Eddyyy/Rocket_FC_Hardware/prototype_rocket_fc/rocket_BOM.ods

Part | Ref | Manufacturer | Part Number | Quantity | Price ($) | Footprint(Package) | Description
Cin | C1,C2 | TDK | C1608X5R1E106M080AC | 2 | 0.2 | 0603 | Cap: 10 µF Total Derated Cap: 680 nF VDC: 25 V ESR: 4.64 mΩ
L1 | L1 | Bourns | SRU8043-150Y | 1 | 1.34 | L_SRU8043 | L: 15 µH DCR: 46 mΩ IDC: 2 A
Cboot | C4 | Kemet | C0603X104K4RACTU | 1 | 0.09 | 0603 | Cap: 100 nF Total Derated Cap: 100 nF VDC: 16 V ESR: 1 mΩ
Cinx | C3 | MuRata | GRM188R71H104KA93D | 1 | 0.02 | 0603 | Cap: 100 nF Total Derated Cap: 93 nF VDC: 50 V ESR: 20 mΩ
U1 | U6 | Texas Instruments | LMR50410XFDBVR | 1 | 0.4 | SOT-23-6 | SIMPLE SWITCHER 4-V TO 36-V, 1-A
Cout | C5,C6 | MuRata | GRM31CR71A226KE15L | 2 | 0.82 | 1206_190 | Cap: 22 µF Total Derated Cap: 27 µF VDC: 10 V ESR: 3.59 mΩ
Renb | R2 | Vishay-Dale | CRCW0603200KFKEA | 1 | 0.01 | 0603 | Resistance: 200 kΩ Tolerance: 1.0% Power: 100 mW
Rent | R1 | Vishay-Dale | CRCW0805665KFKEA | 1 | 0.01 | 0805 | Resistance: 665 kΩ Tolerance: 1.0% Power: 125 mW
Rfbb | R4 | Vishay-Dale | CRCW060322K1FKEA | 1 | 0.01 | 0603 | Resistance: 22.1 kΩ Tolerance: 1.0% Power: 100 mW
Rfbt | R3 | Vishay-Dale | CRCW060388K7FKEA | 1 | 0.01 | 0603 | Resistance: 88.7 kΩ Tolerance: 1.0% Power: 100 mW
 | U7 | Microchip Technology | MIC5504-3.3YM5-TR | 1 | 0.198 | SOT-23-5 | IC REG LINEAR 3.3V 300MA SOT23-5
 | C7,C8 | Samsung Electro-Mechanics | CL10B105KP8NNNC | 2 | 0.14 | 0603 | CAP CER 1UF 10V X7R 0603
 | U1 | RobotDyn | 6970622931676 | 1 | 1.29 | Kevin | High-speed MicroSD-card reader with for FAT and FAT32 file system.
 | U2 | PJRC | TEENSY40_PINS | 1 | 22.95 | Teensy4.0 | Very very small microcontroller
 | U3 | cctv008008 | GY-BMP280 | 1 | 1.4 | kevin | barometer
 | U4 | arduiniana | TinyGPS plus | 1 | 20 | kevin | gps
 | U5 | core electronics | SENS13762 | 1 | 23.3 | kevin | imu
 | J1 | DFRobot | FIT0587 | 1 | 2.03 | AMASS_XT60-M | HIGH QUALITY GOLD PLATED XT60 MA
 | D1 | Ebay |  | 1 | 0 | 0603 | LED_red 2 V_d
 | R5
