Eddyyy/Rocket_FC_Hardware/iteration1_pcbs/iter1_libraries/iteration1.packages3D/U1-BBB_NCH.step

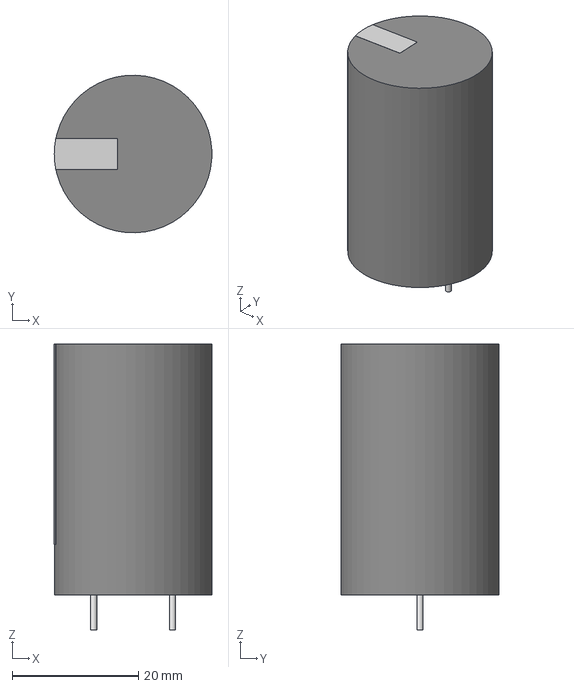
[picture p1: CAD file, 2021-07-13]
iteration1_pcbs/iter1_libraries/iteration1.packages3D/U1-BBB_NCH.step
25.0 x 25.0 x 45.4 mm
