Eddyyy/Rocket_FC_Hardware/kiCad_Projects/prototype_rocket_fc/prototype_rocket_fc-Edge_Cuts.dxf

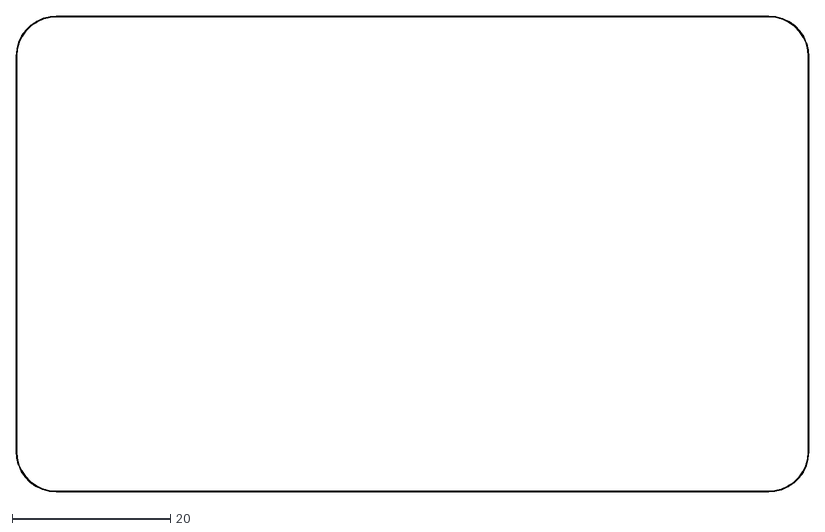
[picture p2: CAD file, 2021-06-23]
kiCad_Projects/prototype_rocket_fc/prototype_rocket_fc-Edge_Cuts.dxf
100.1 x 60.1
