Eddyyy/Rocket_FC_Hardware/prototype_rocket_fc/prototype_rocket_fc-B_Cu.dxf

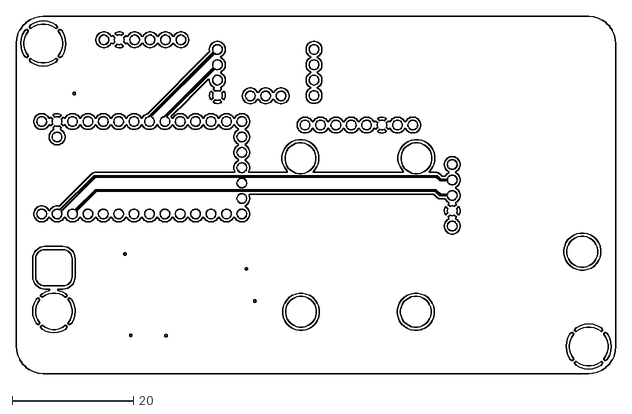
[picture p3: CAD file, 2021-06-23]
prototype_rocket_fc/prototype_rocket_fc-B_Cu.dxf
98.9 x 58.9
