Eddyyy/Rocket_FC_Hardware/iteration1_pcbs/iter1_libraries/iteration1.packages3D/LGA-16_4X4X1_STM.step

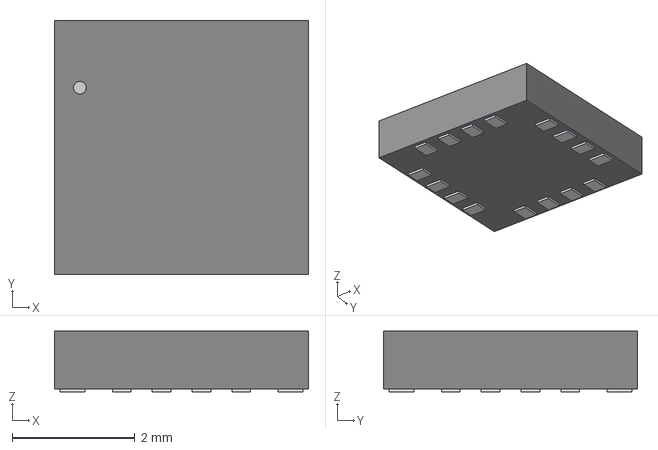
[picture p4: CAD file, 2021-07-08]
iteration1_pcbs/iter1_libraries/iteration1.packages3D/LGA-16_4X4X1_STM.step
4.14 x 4.14 x 0.993 mm
