Eddyyy/Rocket_FC_Hardware/kiCad_Projects/prototype_rocket_fc/prototype_rocket_fc-F_Cu.dxf

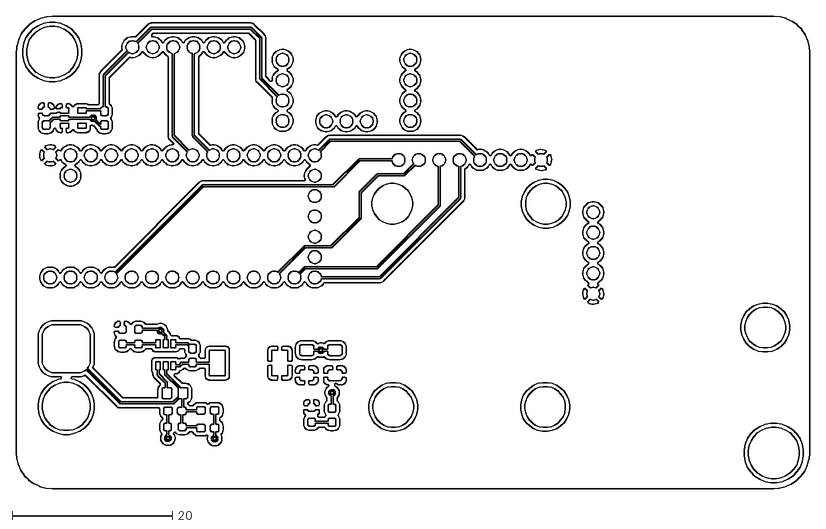
[picture p5: CAD file, 2021-06-23]
kiCad_Projects/prototype_rocket_fc/prototype_rocket_fc-F_Cu.dxf
98.9 x 58.9
