Eddyyy/Rocket_FC_Hardware/iteration1_pcbs/iter1_libraries/iteration1.packages3D/HFW8R-1STE1H1LF.stp

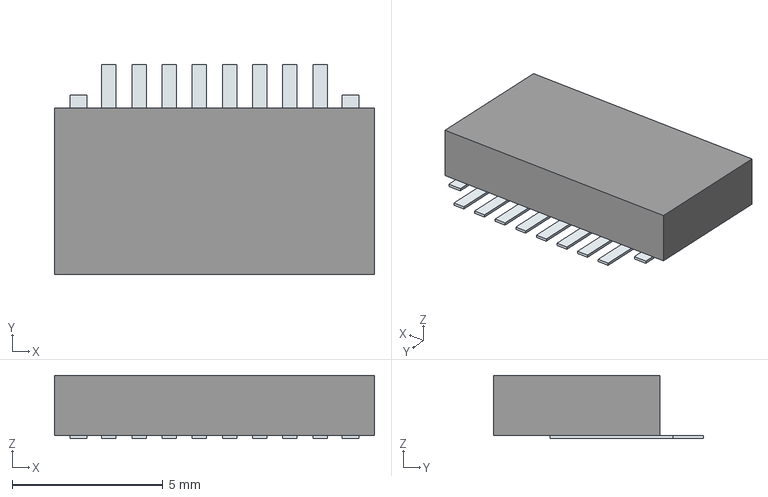
[picture p6: CAD file, 2021-07-08]
iteration1_pcbs/iter1_libraries/iteration1.packages3D/HFW8R-1STE1H1LF.stp
10.6 x 6.94 x 2.10 mm
Pins
