Eddyyy/Rocket_FC_Hardware/iteration1_pcbs/iter1_libraries/iteration1.packages3D/KIONIX_KXTJ3-1057.step

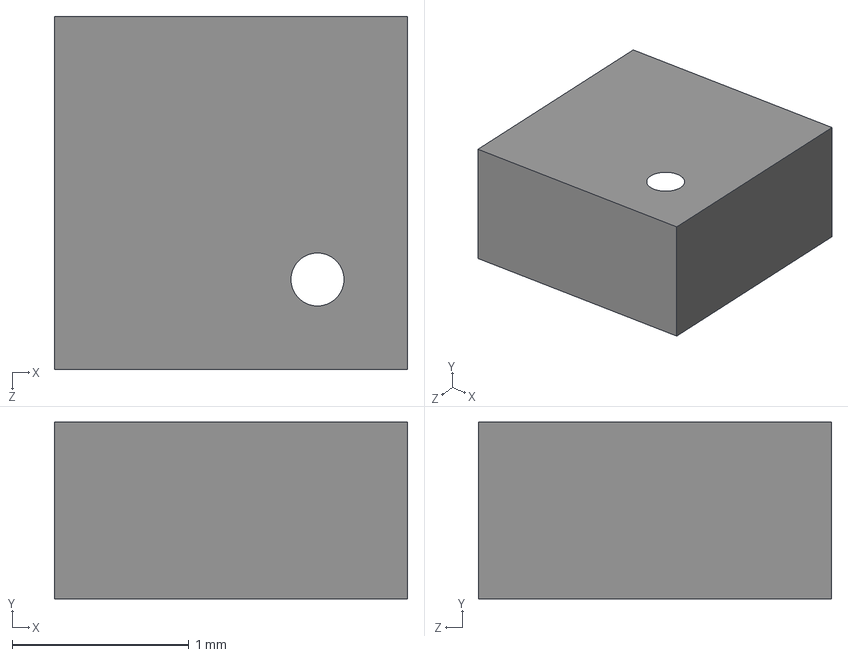
[picture p7: CAD file, 2021-07-08]
iteration1_pcbs/iter1_libraries/iteration1.packages3D/KIONIX_KXTJ3-1057.step
2.00 x 1.00 x 2.00 mm
