Eddyyy/Rocket_FC_Hardware/iteration1_pcbs/iter1_libraries/iteration1.packages3D/WLP4_0P82X0P82_MEM.step

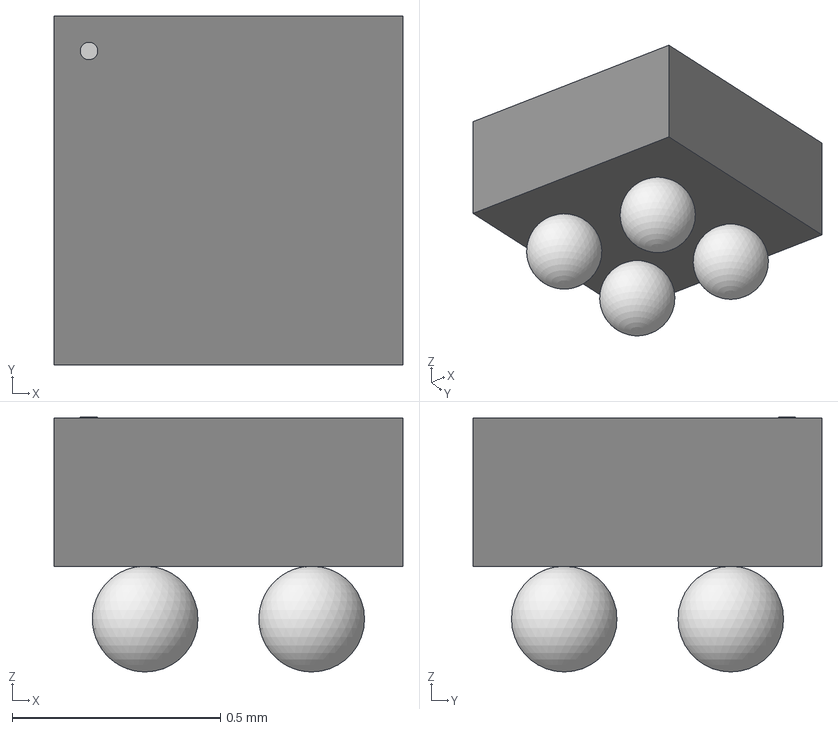
[picture p8: CAD file, 2021-07-08]
iteration1_pcbs/iter1_libraries/iteration1.packages3D/WLP4_0P82X0P82_MEM.step
0.838 x 0.838 x 0.612 mm
