Eddyyy/Rocket_FC_Hardware/iteration1_pcbs/iter1_libraries/iteration1.packages3D/SOIC-8_ME_MCH.step

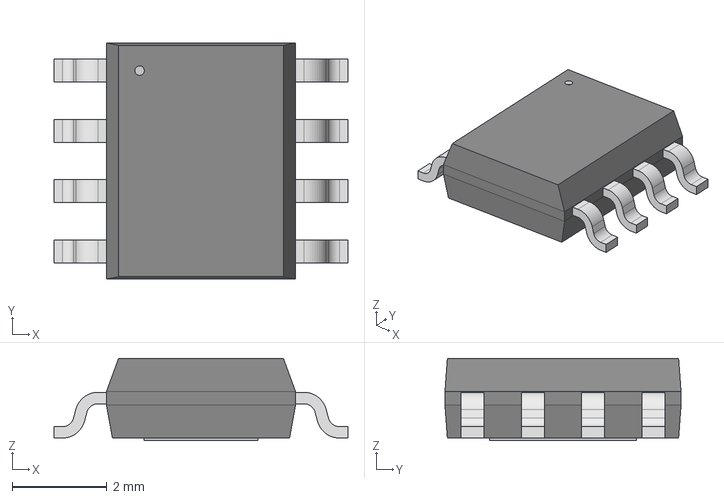
[picture p9: CAD file, 2021-06-24]
iteration1_pcbs/iter1_libraries/iteration1.packages3D/SOIC-8_ME_MCH.step
6.20 x 4.98 x 1.73 mm
