Eddyyy/Rocket_FC_Hardware/iteration1_pcbs/iter1_libraries/iteration1.packages3D/SC-70_SOT323_NEX.step

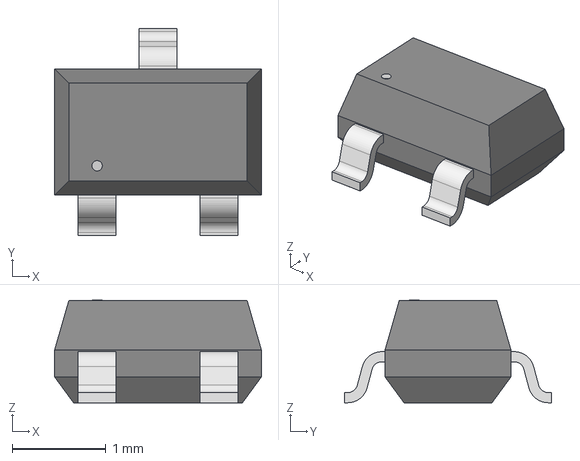
[picture p10: CAD file, 2021-06-24]
iteration1_pcbs/iter1_libraries/iteration1.packages3D/SC-70_SOT323_NEX.step
2.21 x 2.21 x 1.09 mm
