Eddyyy/Rocket_FC_Hardware/iteration1_pcbs/iter1_libraries/iteration1.packages3D/SK220ATR.stp

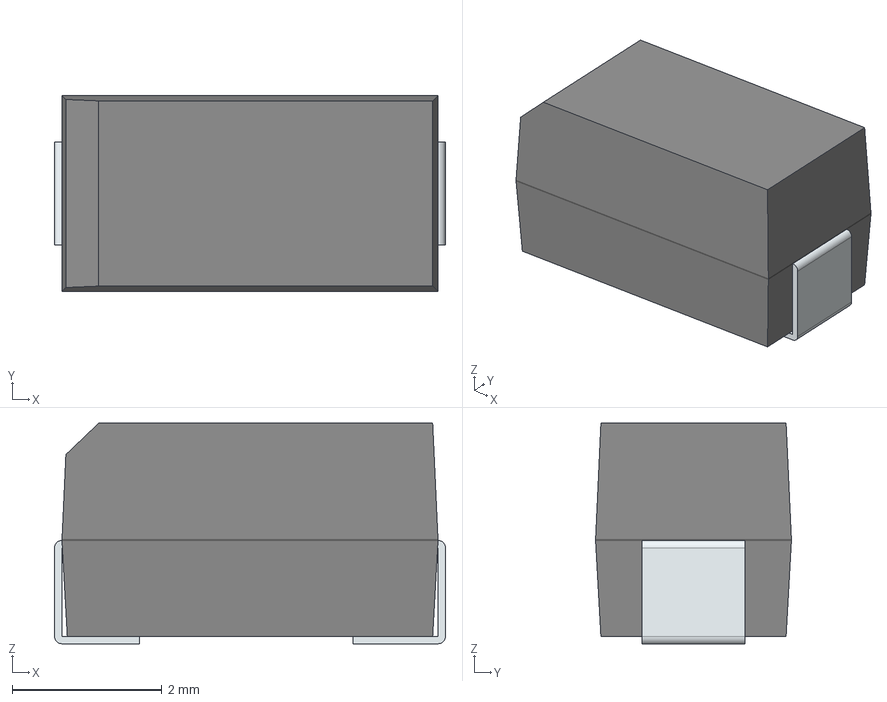
[picture p11: CAD file, 2021-06-23]
iteration1_pcbs/iter1_libraries/iteration1.packages3D/SK220ATR.stp
5.23 x 2.62 x 2.95 mm
FilletPin1
FilletPin2
