Eddyyy/Rocket_FC_Hardware/iteration1_pcbs/iter1_libraries/iteration1.packages3D/LM51571QRTERQ1.stp

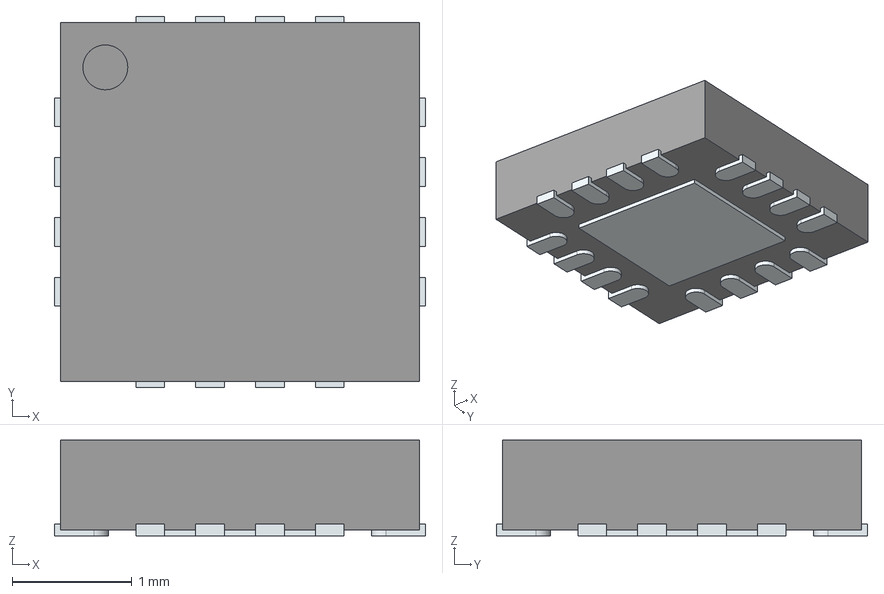
[picture p12: CAD file, 2021-06-23]
iteration1_pcbs/iter1_libraries/iteration1.packages3D/LM51571QRTERQ1.stp
3.10 x 3.10 x 0.8 mm
ThermalPin
PinsArrayLR
PinsArrayTB
