Eddyyy/Rocket_FC_Hardware/iteration1_pcbs/initial_schematics.pdf

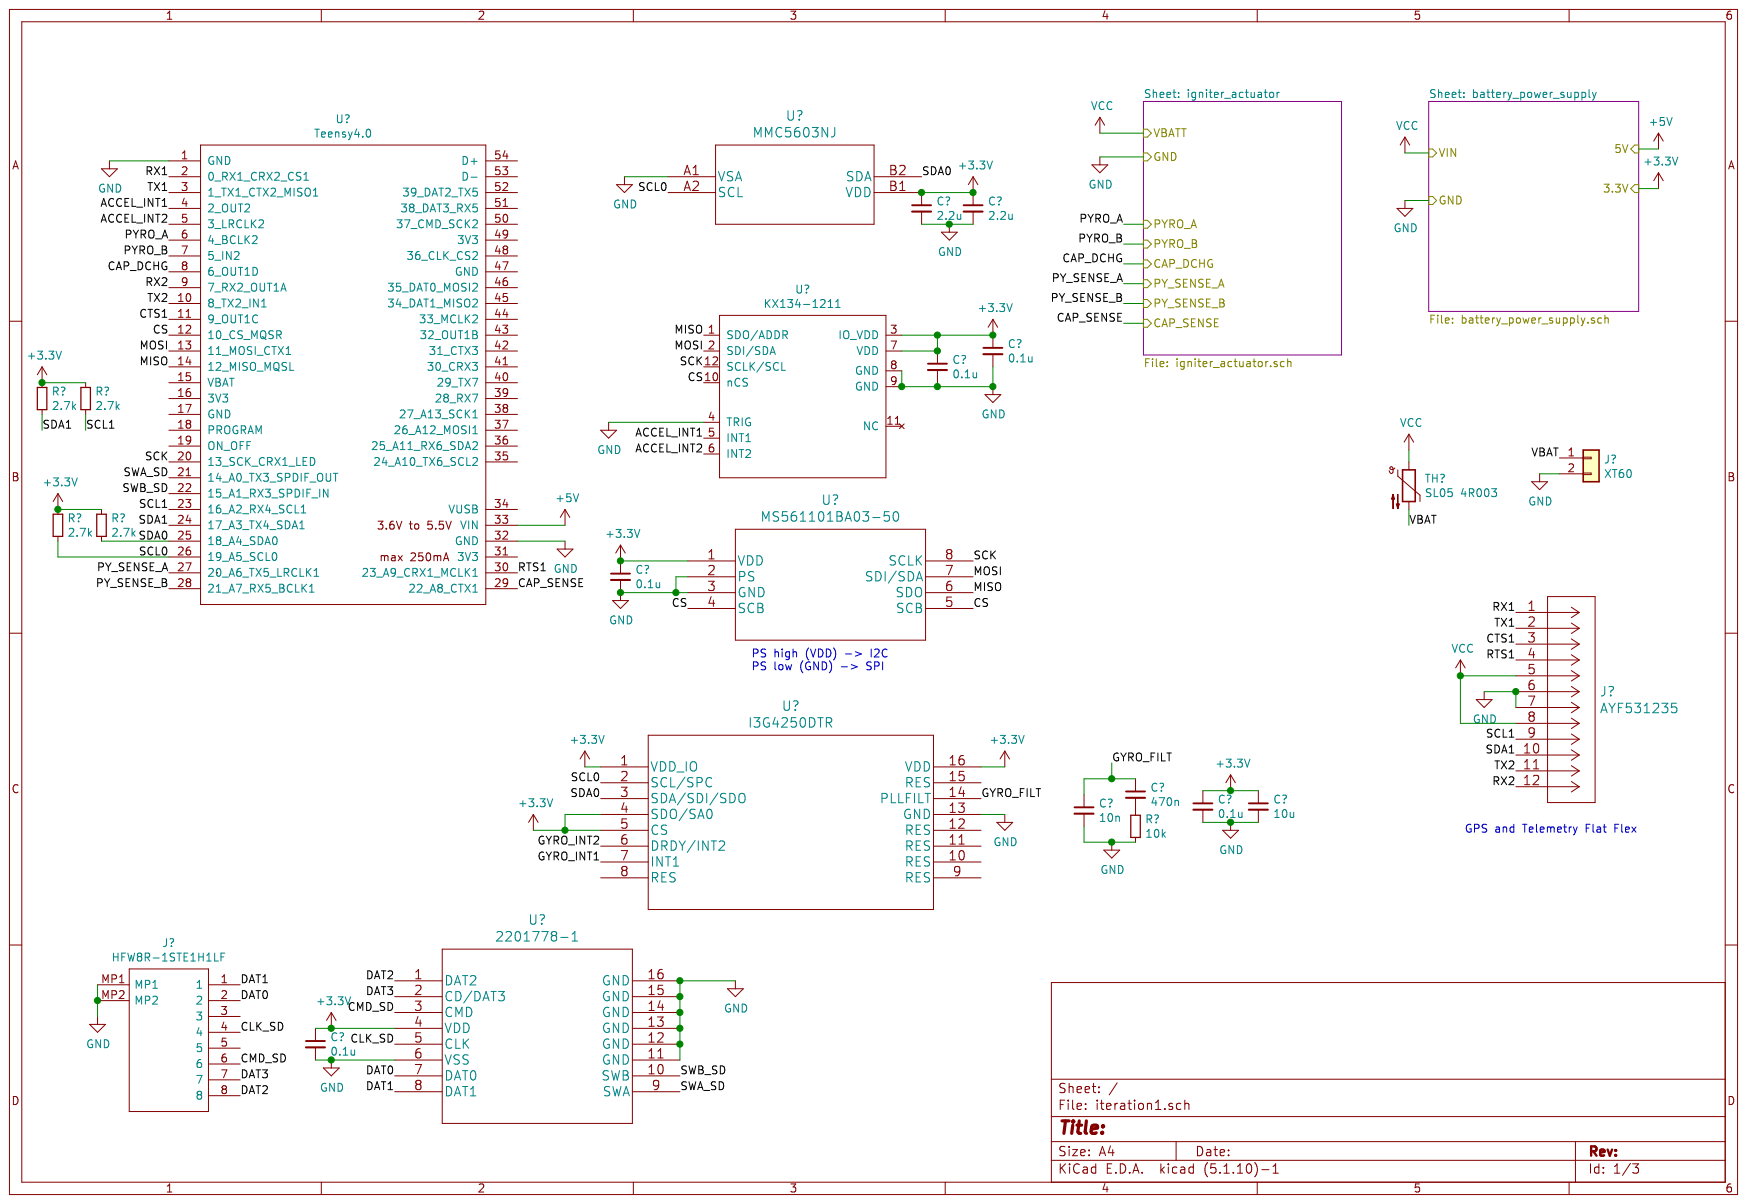
[picture p13: page 1]

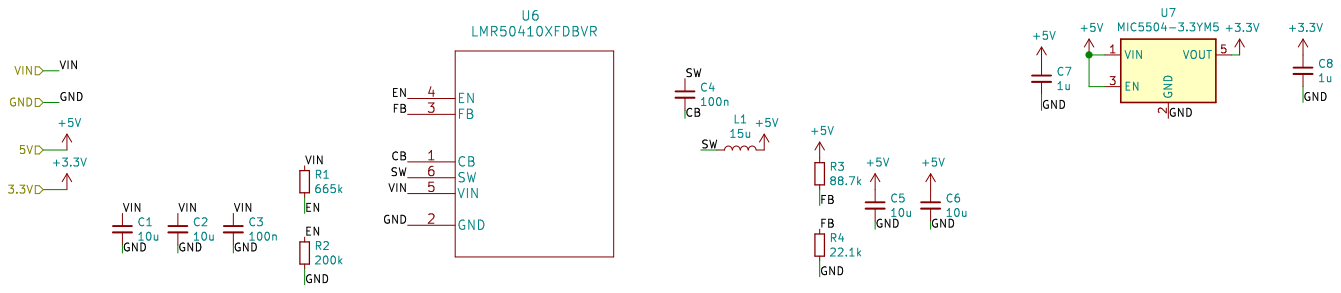
[picture p14: page 2]

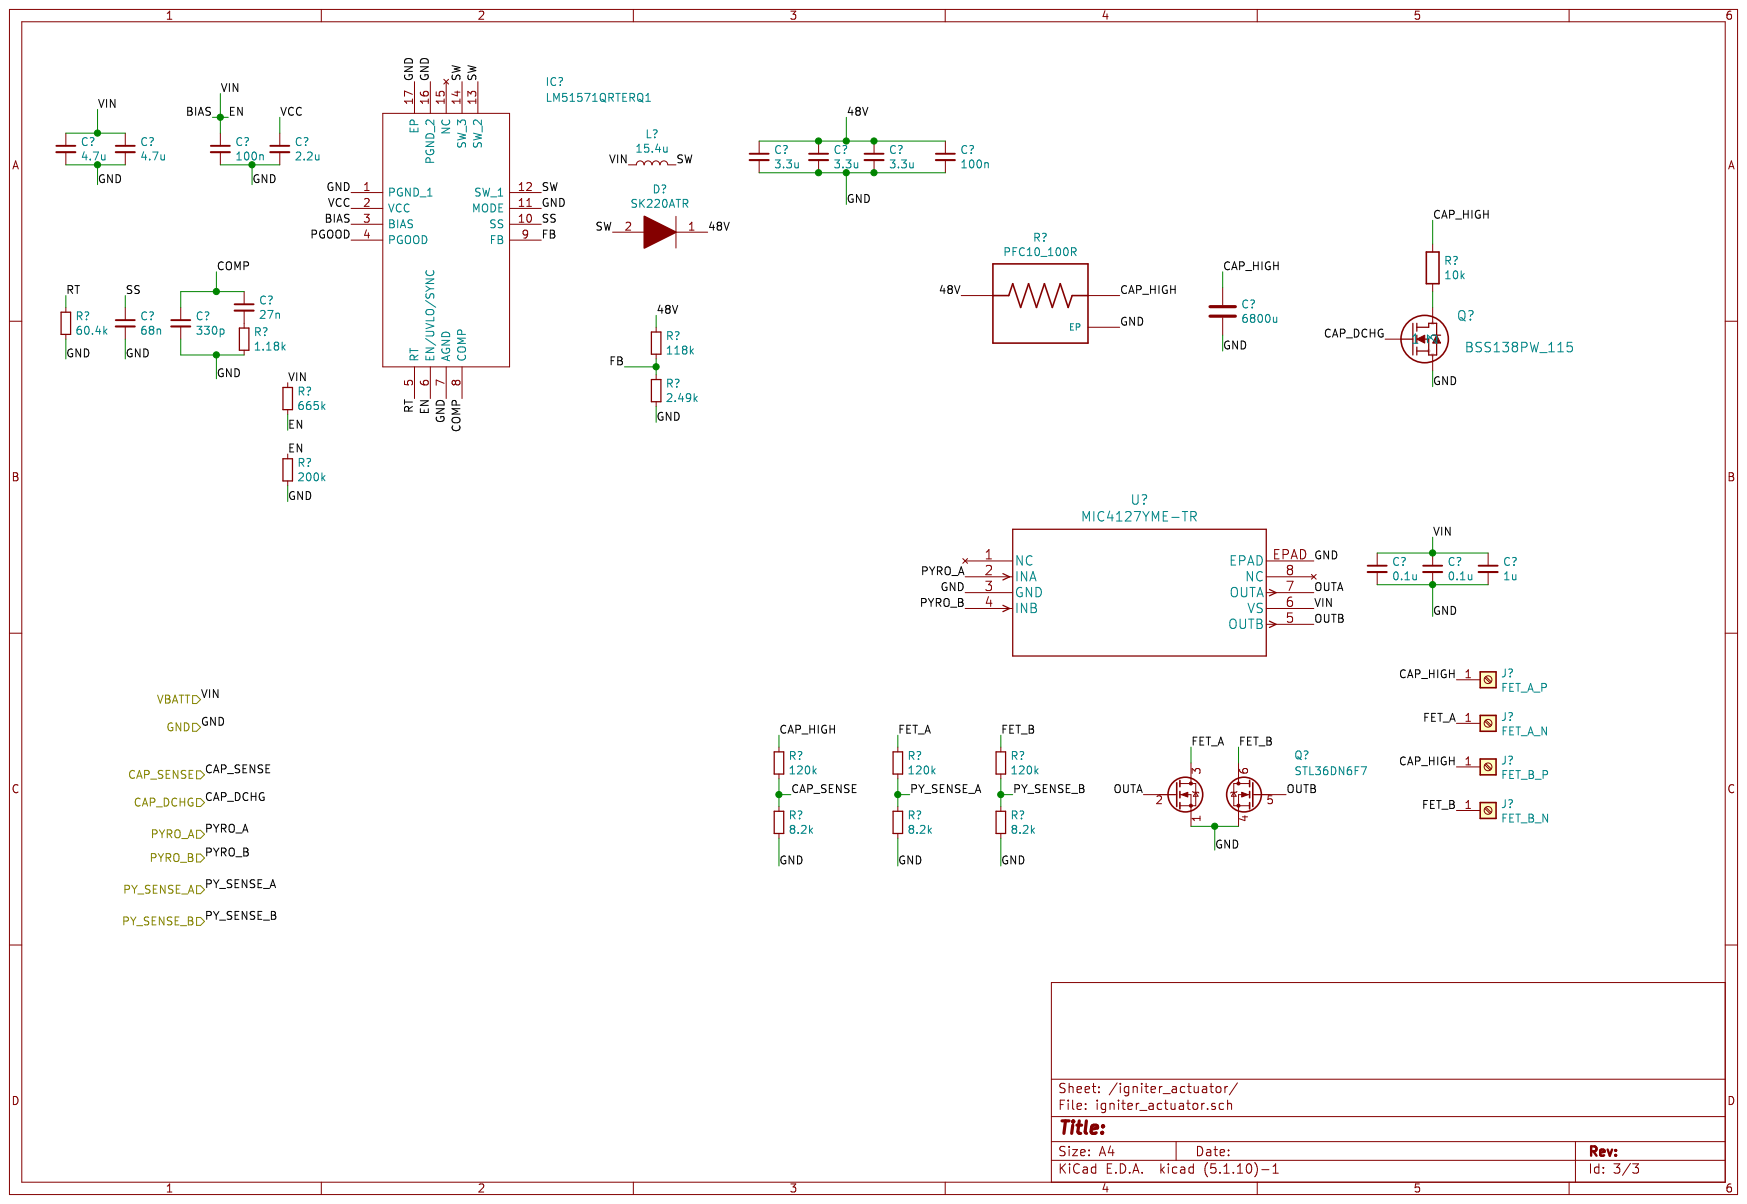
[picture p15: page 3]
