Eddyyy/Rocket_FC_Hardware/iteration1_pcbs/igniter_test/igniter_test.kicad_pcb

## KiCad design iteration1_pcbs/igniter_test/igniter_test.kicad_pcb (2021-09-19)

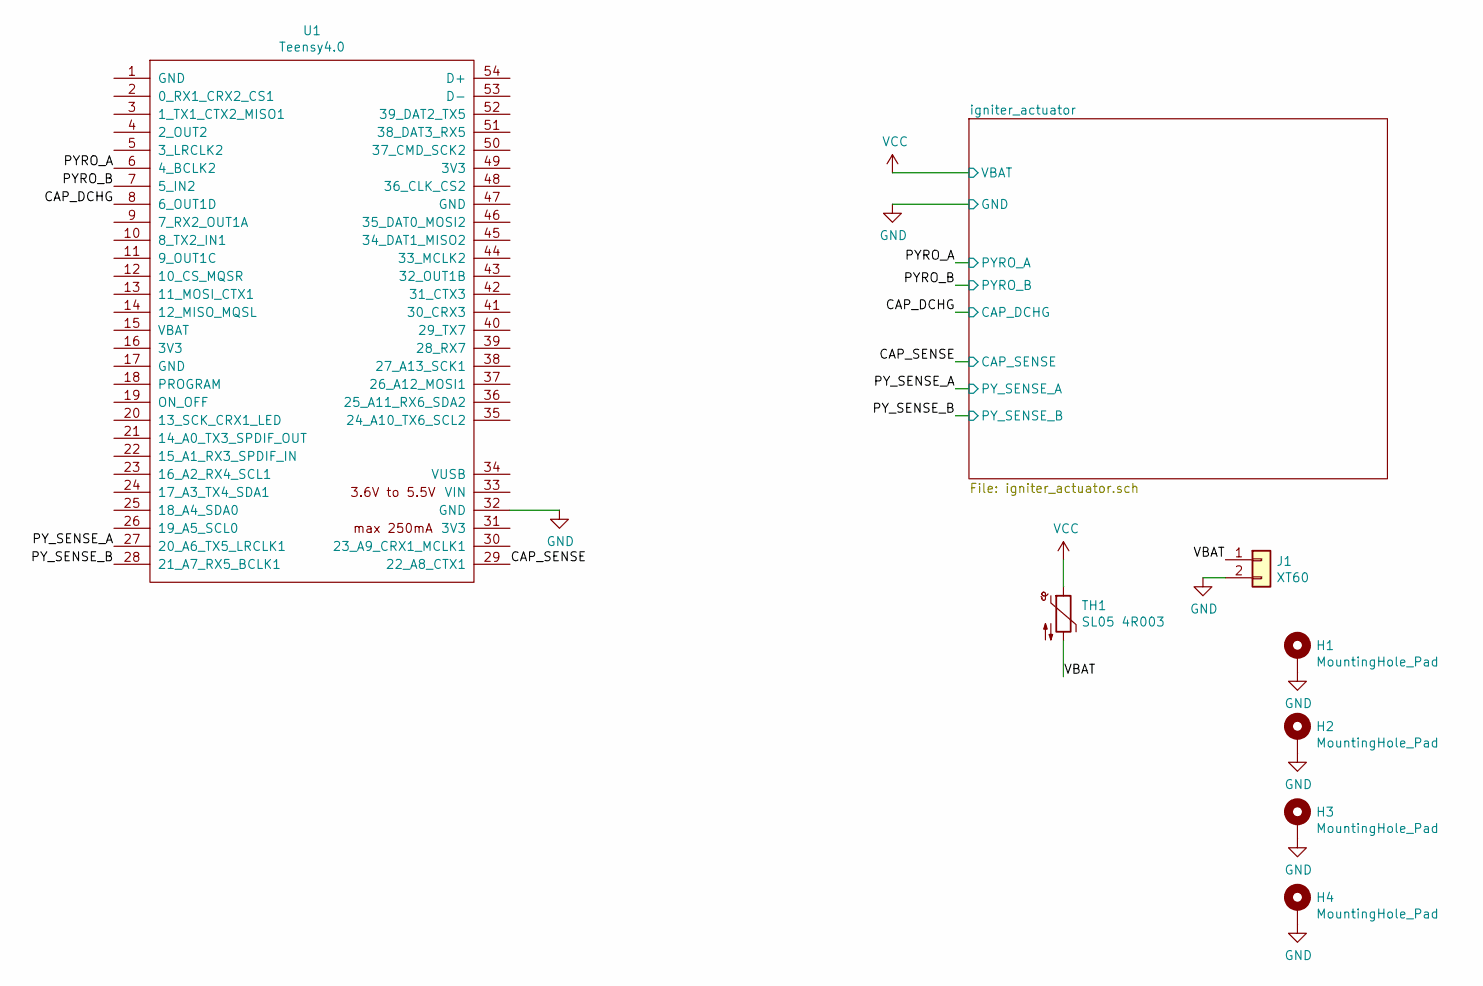
[picture p16: schematic igniter_test.sch]

Parts:
H1, H2, H3, H4: MountingHole_Pad; MountingHole_3.2mm_M3_Pad_Via
J1: XT60; AMASS_XT60-M_1x02_P7.20mm_Vertical
TH1: SL05 4R003; SL05_4R003
U1: Teensy4.0; Teensy40

Connections:
/CAP_DCHG: U1.8 (6_OUT1D); also elsewhere on the board
/CAP_SENSE: U1.29 (22_A8_CTX1); also elsewhere on the board
/PYRO_A: U1.6 (4_BCLK2); also elsewhere on the board
/PYRO_B: U1.7 (5_IN2); also elsewhere on the board
/PY_SENSE_A: U1.27 (20_A6_TX5_LRCLK1); also elsewhere on the board
/PY_SENSE_B: U1.28 (21_A7_RX5_BCLK1); also elsewhere on the board
/VBAT: J1.1, TH1.2
GND: H1.1, H2.1, H3.1, H4.1, J1.2, U1.32 (GND); also elsewhere on the board
VCC: TH1.1; also elsewhere on the board

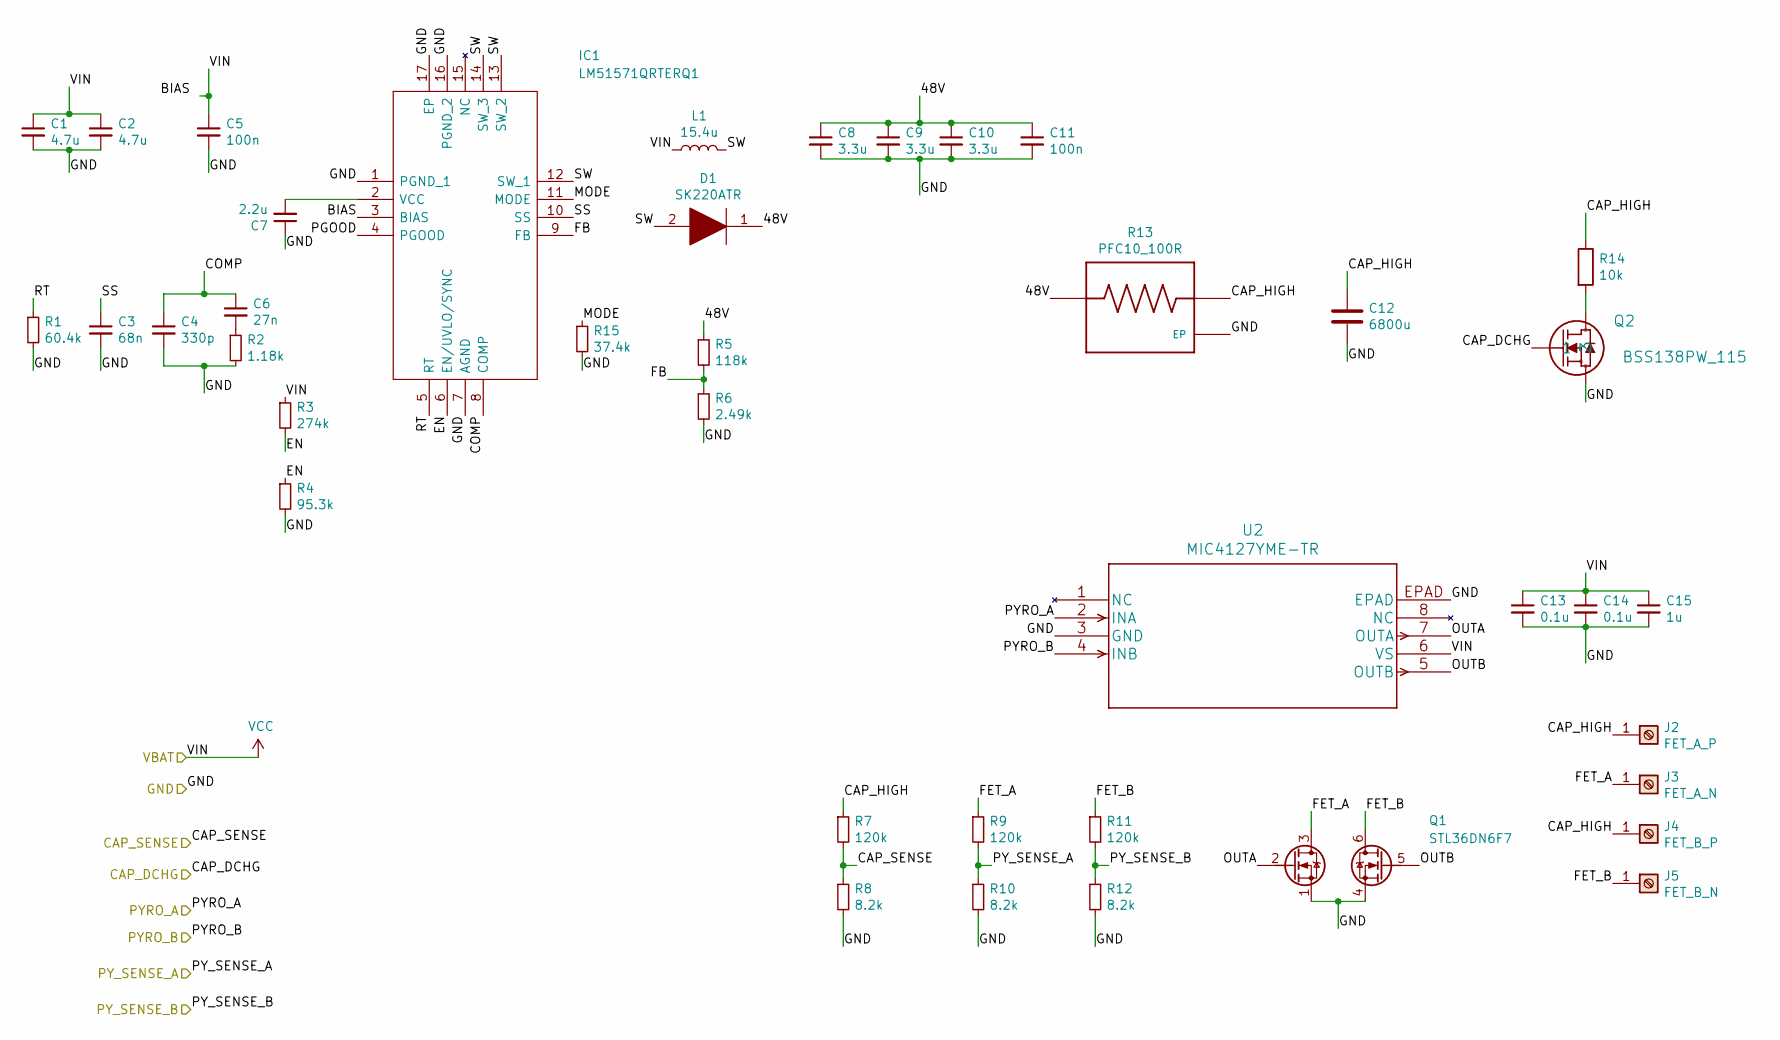
[picture p17: schematic igniter_actuator.sch]

Parts:
C1, C2: 4.7u; C_0805_2012Metric_Pad1.18x1.45mm_HandSolder
C3: 68n; C_0603_1608Metric_Pad1.08x0.95mm_HandSolder
C4: 330p; C_0603_1608Metric_Pad1.08x0.95mm_HandSolder
C5, C11: 100n; C_0805_2012Metric_Pad1.18x1.45mm_HandSolder
C6: 27n; C_0805_2012Metric_Pad1.18x1.45mm_HandSolder
C7: 2.2u; C_0805_2012Metric_Pad1.18x1.45mm_HandSolder
C8, C9, C10: 3.3u; C_1206_3216Metric_Pad1.33x1.80mm_HandSolder
C12: 6800u; UVR1H682MRD6
C13, C14: 0.1u; C_0603_1608Metric_Pad1.08x0.95mm_HandSolder
C15: 1u; C_0603_1608Metric_Pad1.08x0.95mm_HandSolder
D1: SK220ATR
IC1: LM51571QRTERQ1
J2: FET_A_P; SM99S01VBNN05G7
J3: FET_A_N; SM99S01VBNN05G7
J4: FET_B_P; SM99S01VBNN05G7
J5: FET_B_N; SM99S01VBNN05G7
L1: 15.4u; L_Wuerth_HCI-1365
Q1: STL36DN6F7; VDFN_5x6
Q2: BSS138PW_115
R1: 60.4k; R_0603_1608Metric_Pad0.98x0.95mm_HandSolder
R2: 1.18k; R_0603_1608Metric_Pad0.98x0.95mm_HandSolder
R3: 274k; R_0603_1608Metric_Pad0.98x0.95mm_HandSolder
R4: 95.3k; R_0603_1608Metric_Pad0.98x0.95mm_HandSolder
R5: 118k; R_0603_1608Metric_Pad0.98x0.95mm_HandSolder
R6: 2.49k; R_0603_1608Metric_Pad0.98x0.95mm_HandSolder
R7, R9, R11: 120k; R_0603_1608Metric_Pad0.98x0.95mm_HandSolder
R8, R10, R12: 8.2k; R_0603_1608Metric_Pad0.98x0.95mm_HandSolder
R13: PFC10_100R; RES_PFC10
R14: 10k; R_0805_2012Metric_Pad1.20x1.40mm_HandSolder
R15: 37.4k; R_0603_1608Metric_Pad0.98x0.95mm_HandSolder
U2: MIC4127YME-TR

Connections:
/CAP_DCHG: Q2.1; also elsewhere on the board
/CAP_SENSE: R7.2, R8.1; also elsewhere on the board
/PYRO_A: U2.2 (INA); also elsewhere on the board
/PYRO_B: U2.4 (INB); also elsewhere on the board
/PY_SENSE_A: R9.2, R10.1; also elsewhere on the board
/PY_SENSE_B: R11.2, R12.1; also elsewhere on the board
/igniter_actuator/48V: C8.1, C9.1, C10.1, C11.1, D1.1, R5.1, R13.1
/igniter_actuator/BIAS: IC1.3 (BIAS)
/igniter_actuator/CAP_HIGH: C12.1, J2.1, J4.1, R7.1, R13.2, R14.1
/igniter_actuator/COMP: C4.1, C6.1, IC1.8 (COMP)
/igniter_actuator/EN: IC1.6 (EN/UVLO/SYNC), R3.2, R4.1
/igniter_actuator/FB: IC1.9 (FB), R5.2, R6.1
/igniter_actuator/FET_A: J3.1, Q1.3 (D), R9.1
/igniter_actuator/FET_B: J5.1, Q1.6 (D), R11.1
/igniter_actuator/MODE: IC1.11 (MODE), R15.1
/igniter_actuator/OUTA: Q1.2 (G), U2.7 (OUTA)
/igniter_actuator/OUTB: Q1.5 (G), U2.5 (OUTB)
/igniter_actuator/PGOOD: IC1.4 (PGOOD)
/igniter_actuator/RT: IC1.5 (RT), R1.1
/igniter_actuator/SS: C3.1, IC1.10 (SS)
/igniter_actuator/SW: D1.2, IC1.12 (SW_1), IC1.13 (SW_2), IC1.14 (SW_3), L1.2
GND: C1.2, C2.2, C3.2, C4.2, C5.2, C7.1, C8.2, C9.2, C10.2, C11.2, C12.2, C13.2, C14.2, C15.2, IC1.1 (PGND_1), IC1.7 (AGND), IC1.16 (PGND_2), IC1.17 (EP), Q1.1 (S), Q1.4 (S), Q2.2, R1.2, R2.2, R4.2, R6.2, R8.2, R10.2, R12.2, R13.3 (EP), R15.2, U2.3 (GND), U2.EPAD; also elsewhere on the board
unnamed: C6.2, R2.1
unnamed: C7.2, IC1.2 (VCC)
unnamed: Q2.3, R14.2
VCC: C1.1, C2.1, C5.1, C13.1, C14.1, C15.1, L1.1, R3.1, U2.6 (VS); also elsewhere on the board

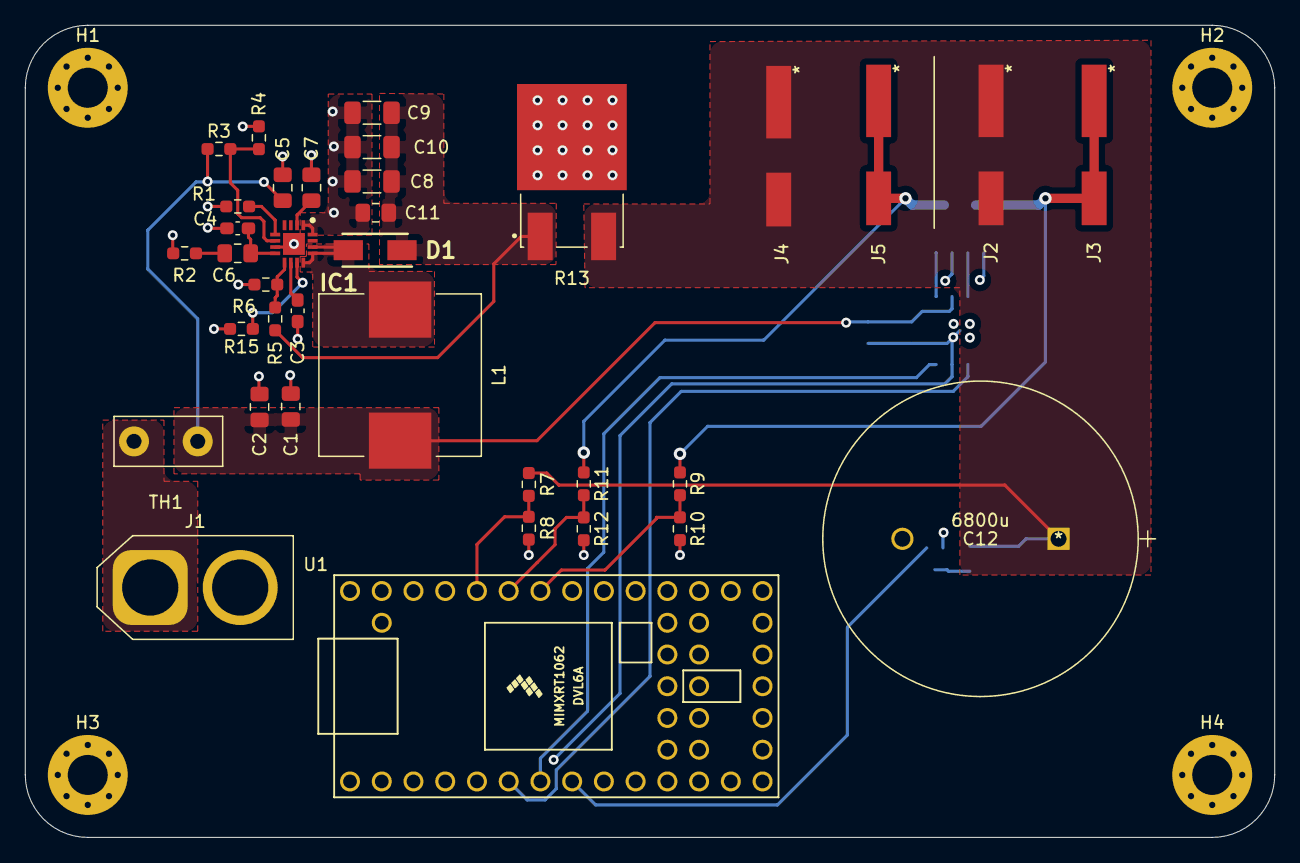
[picture p18: board igniter_test.kicad_pcb from above]

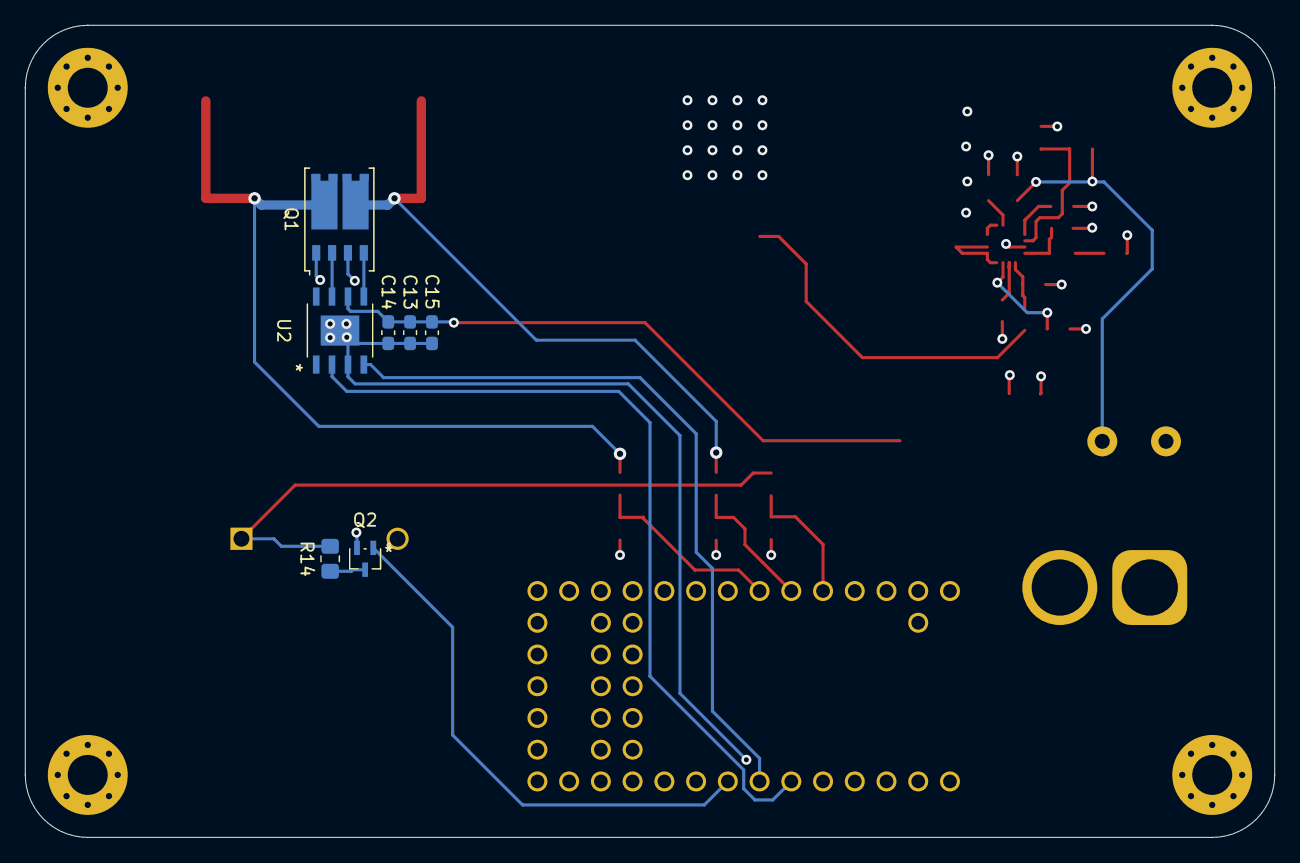
[picture p19: board igniter_test.kicad_pcb from below]

Board: 4 copper layers, 100.0 x 65.0 mm, 47 parts (7 on the bottom side), 25 nets.
