Eddyyy/Rocket_FC_Hardware/prototype_rocket_fc/prototype_rocket_fc.kicad_pcb

## KiCad design prototype_rocket_fc/prototype_rocket_fc.kicad_pcb (2021-06-23)

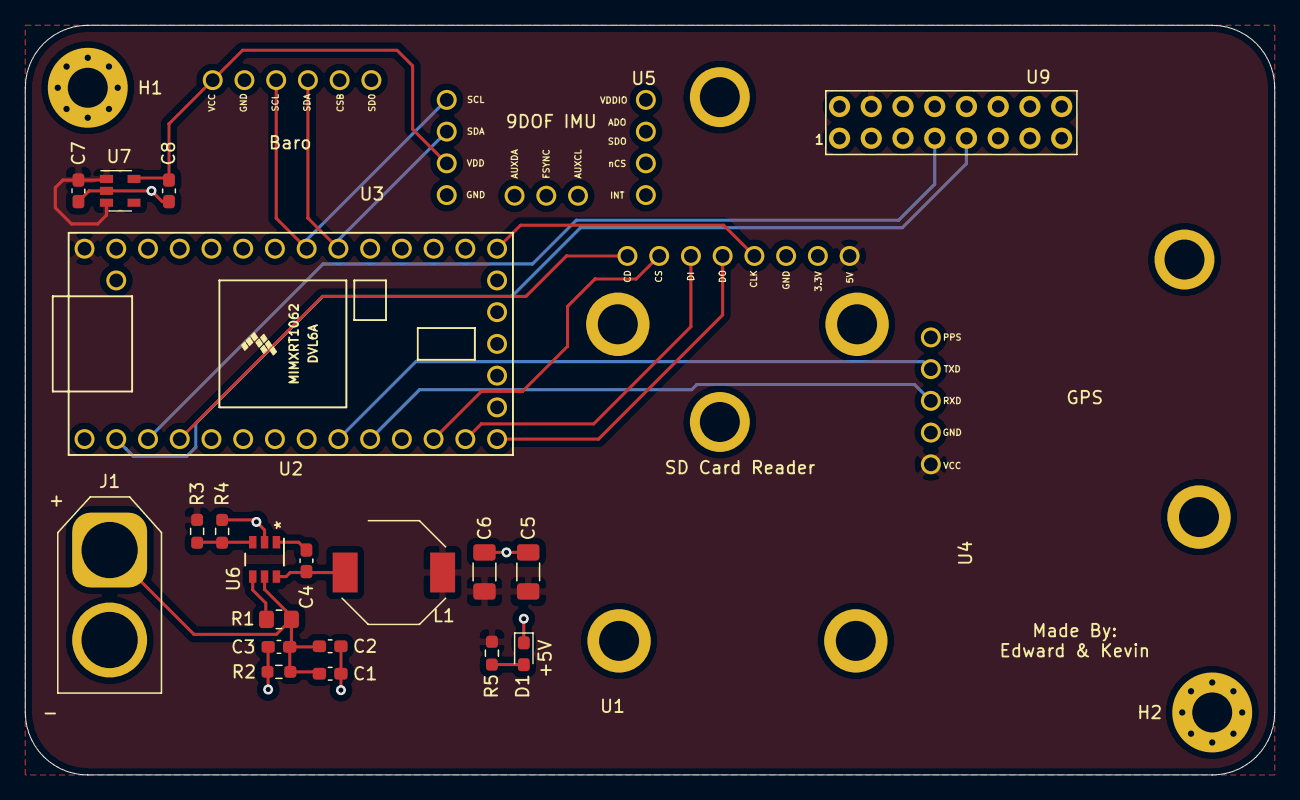
[picture p20: board prototype_rocket_fc.kicad_pcb from above]

Board: 2 copper layers, 100.0 x 60.0 mm, 27 parts (1 on the bottom side), 20 nets.

Parts:
C1, C2: 10u; C_0603_1608Metric_Pad1.08x0.95mm_HandSolder
C3, C4: 100n; C_0603_1608Metric_Pad1.08x0.95mm_HandSolder
C5, C6: 10u; C_1206_3216Metric_Pad1.33x1.80mm_HandSolder
C7, C8: 1u; C_0603_1608Metric_Pad1.08x0.95mm_HandSolder
D1: LED; LED_0603_1608Metric_Pad1.05x0.95mm_HandSolder
H1, H2: MountingHole_Pad; MountingHole_3.2mm_M3_Pad_Via
J1: BATTERY_IN; AMASS_XT60-M_1x02_P7.20mm_Vertical
L1: 15u; L_Bourns-SRU8043
R1: 665k; R_0805_2012Metric_Pad1.20x1.40mm_HandSolder
R2: 200k; R_0603_1608Metric_Pad0.98x0.95mm_HandSolder
R3: 88.7k; R_0603_1608Metric_Pad0.98x0.95mm_HandSolder
R4: 22.1k; R_0603_1608Metric_Pad0.98x0.95mm_HandSolder
R5: 200; R_0603_1608Metric_Pad0.98x0.95mm_HandSolder
U1: SD_Card_Reader; RobotDyn_SD_Card_Reader
U2: Teensy4.0; Teensy40
U3: GY-BMP280
U4: TinyGPS++
U5: MPU9250_custom; MPU9250
U6: LMR50410XFDBVR
U7: MIC5504-3.3YM5; SOT-23-5
U8: RFD900x_Mech
U9: RFD900x_Pins

Connections:
+3V3: C8.1, U3.1, U5.3, U7.5
+5V: C5.1, C6.1, C7.1, L1.2, R3.1, R5.1, U1.1, U2.33, U4.5, U7.1, U7.3, U9.4
/CD: U1.8, U2.4
/CS: U1.7, U2.12
/MISO: U1.5, U2.14
/MOSI: U1.6, U2.13
/RX1: U2.2, U9.9
/RX2: U2.9, U4.2
/SCK: U1.4, U2.20
/SCL0: U2.26, U3.3, U5.1
/SDA0: U2.25, U3.4, U5.2
/TX1: U2.3, U9.7
/TX2: U2.10, U4.3
/battery_power_supply/CB: C4.2, U6.1
/battery_power_supply/EN: R1.2, U6.4
/battery_power_supply/FB: R3.2, R4.1, U6.3
/battery_power_supply/SW: C4.1, L1.1, U6.6
GND: C1.2, C2.2, C3.2, C5.2, C6.2, C7.2, C8.2, D1.1, H1.1, H2.1, J1.2, R2.2, R4.2, U1.3, U2.32, U3.2, U4.4, U5.4, U6.2, U7.2, U8.1, U9.1
unnamed: D1.2, R5.2
VCC: C1.1, C2.1, C3.1, J1.1, R1.1, R2.1, U6.5
