Eddyyy/Rocket_FC_Hardware/(commit log)

2021-06-23 Adding files from old repo
    [EDI2CAP.CFG, LM51571QRTERQ1.stl, LM51571QRTERQ1.stp, SK220ATR.stl, SK220ATR.stp, battery_power_supply.sch, chips.prt, diom5226x295n.psm]
2021-06-24 Cleaning individual part files and adding igniter actuator circuits
    [EDI2CAP.CFG, LM51571QRTERQ1.stl, LM51571QRTERQ1.stp, SC-70_SOT323_NEX.step, SK220ATR.stl, SK220ATR.stp, SOIC-8_ME_MCH.step, battery_power_supply.sch]
2021-07-08 Adding schematic work
    [battery_power_supply.sch, igniter_actuator.sch, iteration1.sch]
2021-07-08 Added more library work
    [HFW8R-1STE1H1LF.stp, KIONIX_KXTJ3-1057.step, LGA-16_4X4X1_STM.step, WLP4_0P82X0P82_MEM.step]
2021-07-10 Reorganising pcb folders and adding test pcb
    [HFW8R-1STE1H1LF.stp, KIONIX_KXTJ3-1057.step, LGA-16_4X4X1_STM.step, LM51571QRTERQ1.stp, SC-70_SOT323_NEX.step, SK220ATR.stp, SOIC-8_ME_MCH.step, WLP4_0P82X0P82_MEM.step]
2021-07-11 Starting the igniter pcb
    [HFW8R-1STE1H1LF.stp, KIONIX_KXTJ3-1057.step, LGA-16_4X4X1_STM.step, LM51571QRTERQ1.stp, SC-70_SOT323_NEX.step, SK220ATR.stp, SOIC-8_ME_MCH.step, WLP4_0P82X0P82_MEM.step]
2021-07-13 Adding igniter testing
    [U1-BBB_NCH.step, igniter_actuator.sch, igniter_test.kicad_pcb, igniter_test.sch]
2021-07-17 Laying out and wiring the igniter test pcb
    [igniter_actuator.sch, igniter_test.kicad_pcb]
2021-07-25 igniter test tracks
    [igniter_actuator.sch, igniter_test.kicad_pcb, igniter_test.sch]
2021-09-19 Adding most of the changes, almost don
    [igniter_test.kicad_pcb, igniter_test.sch]
